RononDex/PipeItUp/README.md

# Pipe It Up

Das offizielle Code Repository für das FHNW IP12 Projekt "Pipe-It-Up".

## Dokumentation
Die Dokumentation für das Projekt kann hier auf [Confluence](https://www.cs.technik.fhnw.ch/confluence20/display/VT122106/IP12-21vt_Pipelinesystem) gefunden werden.
