RononDex/PipeItUp/3D_Print/Display-Attachment/STL/Display-Attachment.stl

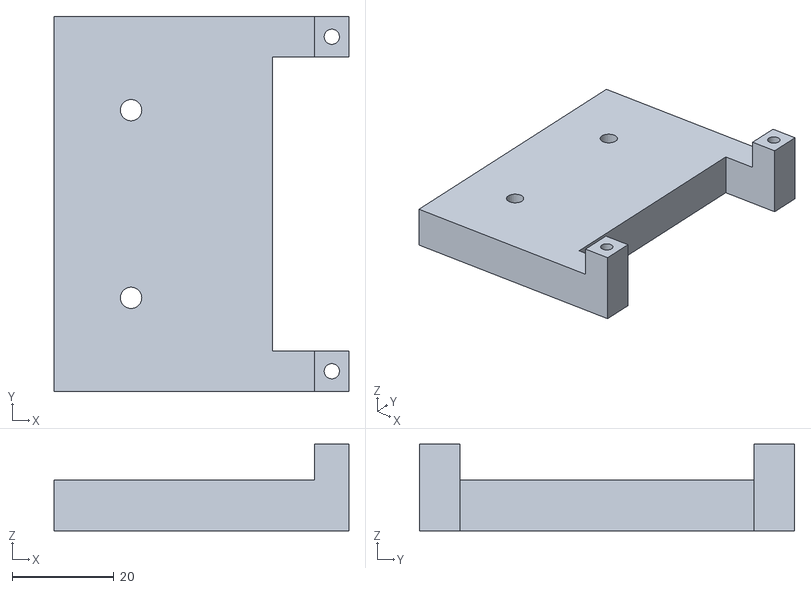
[picture p19: CAD file, 2022-05-26]
3D_Print/Display-Attachment/STL/Display-Attachment.stl
57.9 x 73.7 x 17.0
