RononDex/PipeItUp/3D_Print/Knoten/STL/Knoten_NR14.stl

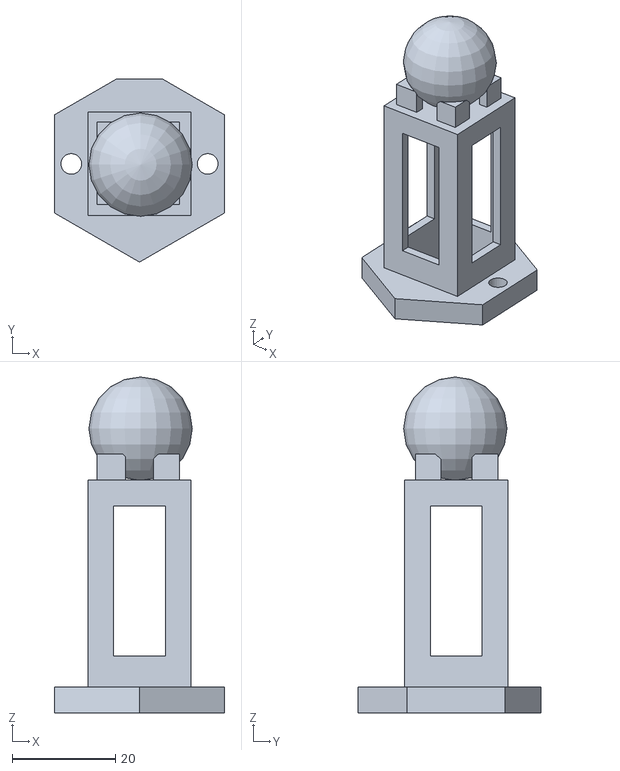
[picture p20: CAD file, 2022-05-26]
3D_Print/Knoten/STL/Knoten_NR14.stl
32.9 x 35.5 x 65.0
