RononDex/PipeItUp/3D_Print/PipeItUp_Logo/STL/PipeItUp_Logo.stl

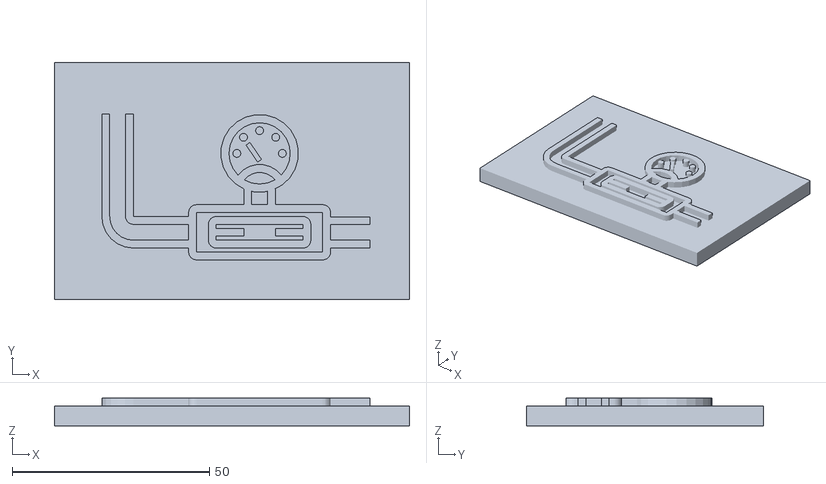
[picture p21: CAD file, 2022-05-26]
3D_Print/PipeItUp_Logo/STL/PipeItUp_Logo.stl
90.0 x 60.0 x 7.00
