RononDex/PipeItUp/3D_Print/Schiene/STL/Schiene.stl

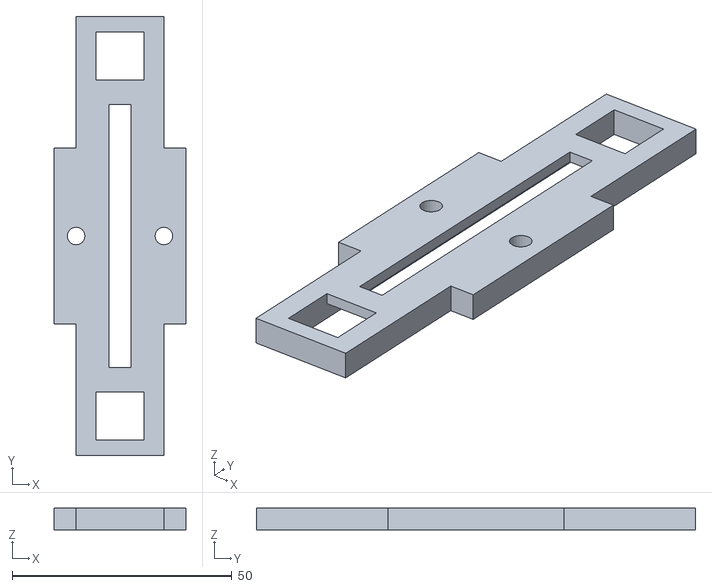
[picture p22: CAD file, 2022-05-26]
3D_Print/Schiene/STL/Schiene.stl
30.0 x 100.0 x 5.00
