RononDex/PipeItUp/3D_Print/Säule/STL/Säule.stl

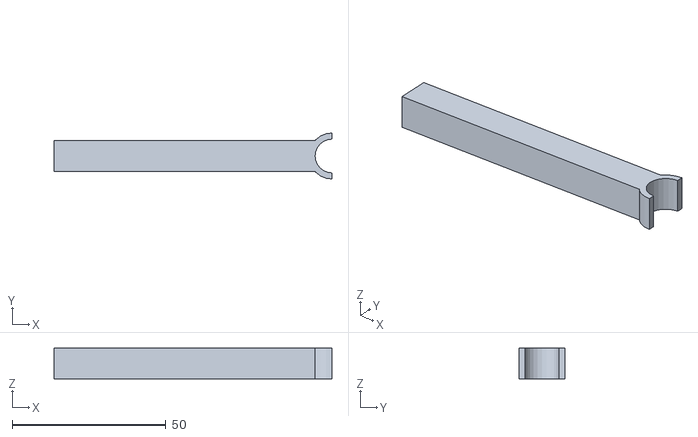
[picture p23: CAD file, 2022-05-26]
3D_Print/Säule/STL/Säule.stl
90.5 x 15.0 x 10.0
