RononDex/PipeItUp/3D_Print/Top-Platform/STL/Top-Platform.stl

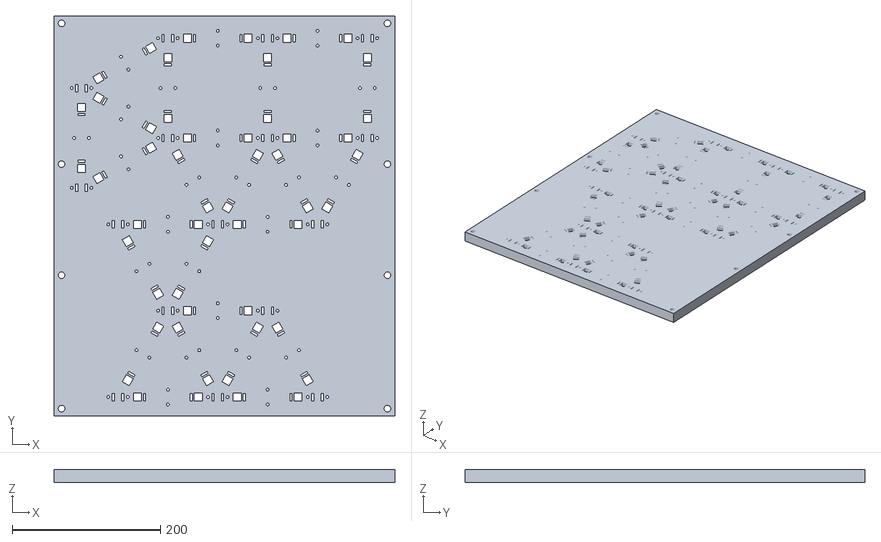
[picture p24: CAD file, 2022-05-26]
3D_Print/Top-Platform/STL/Top-Platform.stl
460.0 x 540.0 x 18.0
