RononDex/PipeItUp/3D_Print/Bottom-Platform/STL/Bottom-Platform_DRUCK_NR1.stl

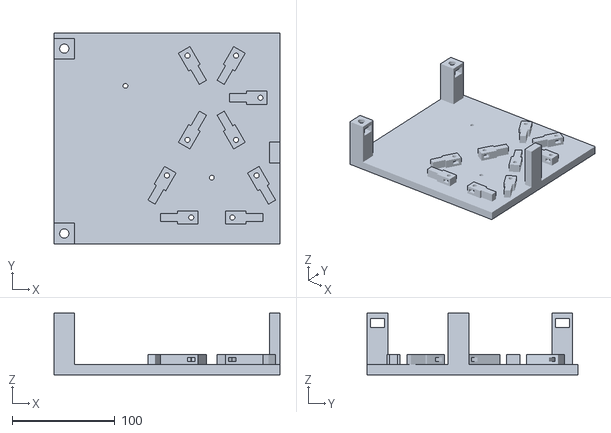
[picture p25: CAD file, 2022-05-26]
3D_Print/Bottom-Platform/STL/Bottom-Platform_DRUCK_NR1.stl
220.0 x 205.0 x 60.0
