RononDex/PipeItUp/3D_Print/Knoten/STL/Knoten_NR6.stl

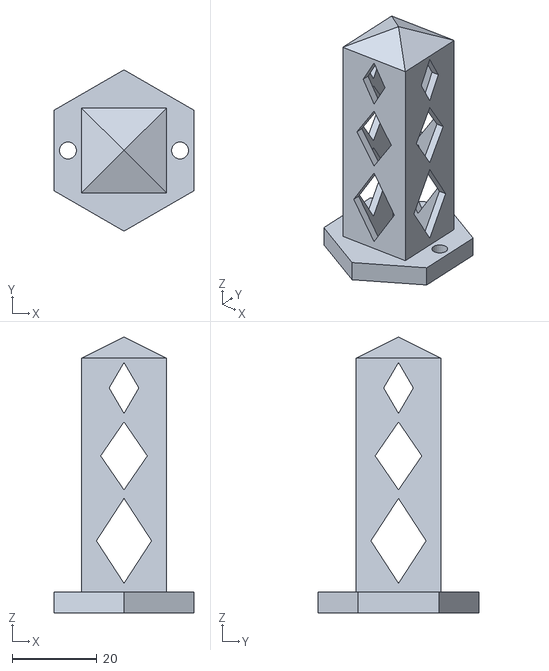
[picture p26: CAD file, 2022-05-26]
3D_Print/Knoten/STL/Knoten_NR6.stl
32.9 x 38.0 x 65.0
