RononDex/PipeItUp/3D_Print/Bottom-Platform/STL/Bottom-Platform_DRUCK_NR5.stl

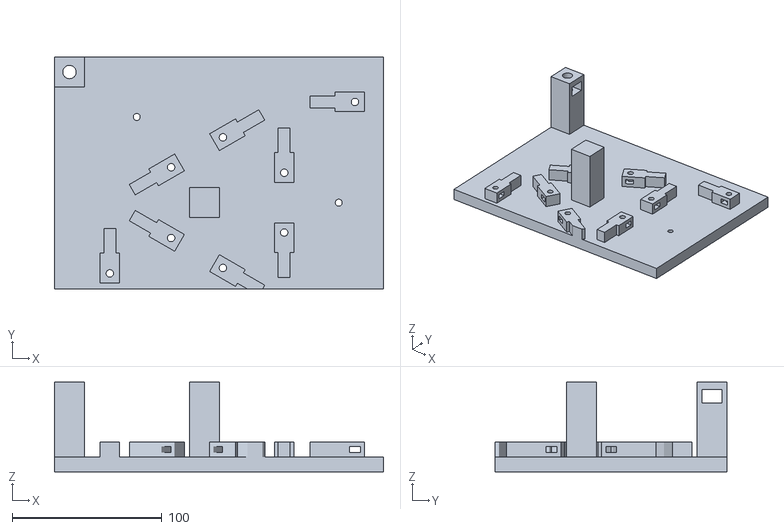
[picture p27: CAD file, 2022-05-26]
3D_Print/Bottom-Platform/STL/Bottom-Platform_DRUCK_NR5.stl
220.0 x 155.0 x 60.0
