RononDex/PipeItUp/3D_Print/Bottom-Platform/STL/Bottom-Platform_DRUCK_NR3.stl

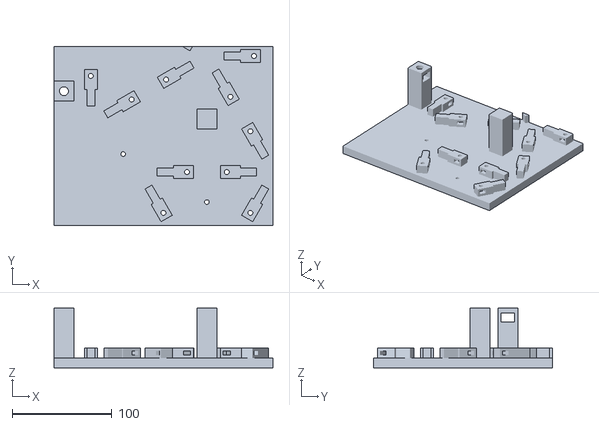
[picture p29: CAD file, 2022-05-26]
3D_Print/Bottom-Platform/STL/Bottom-Platform_DRUCK_NR3.stl
220.0 x 180.0 x 60.0
