RononDex/PipeItUp/3D_Print/Knoten/STL/Knoten_NR4.stl

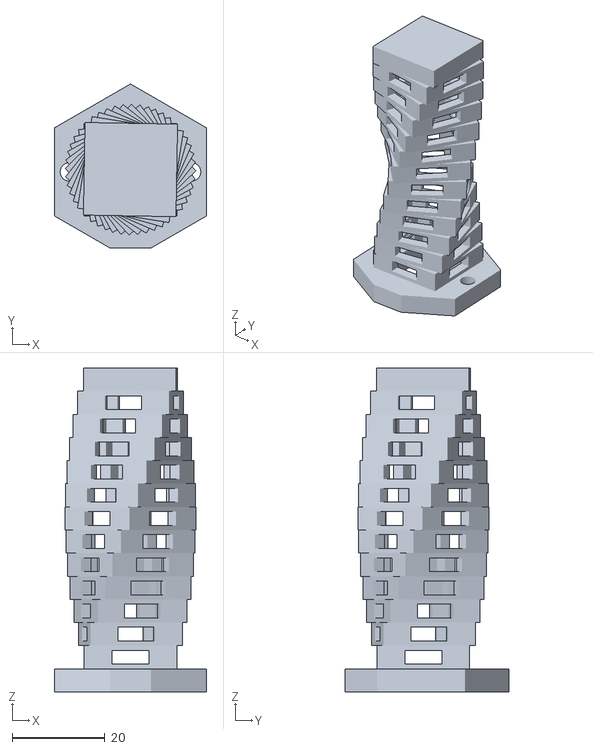
[picture p32: CAD file, 2022-05-26]
3D_Print/Knoten/STL/Knoten_NR4.stl
32.9 x 35.5 x 70.0
