RononDex/PipeItUp/3D_Print/Knoten/STL/Knoten_NR12.stl

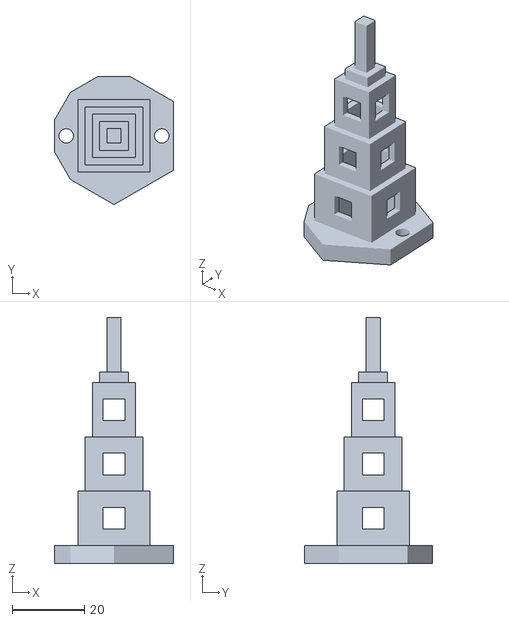
[picture p33: CAD file, 2022-05-26]
3D_Print/Knoten/STL/Knoten_NR12.stl
32.9 x 35.5 x 68.0
