RononDex/PipeItUp/3D_Print/Knoten/STL/Knoten_NR11.stl

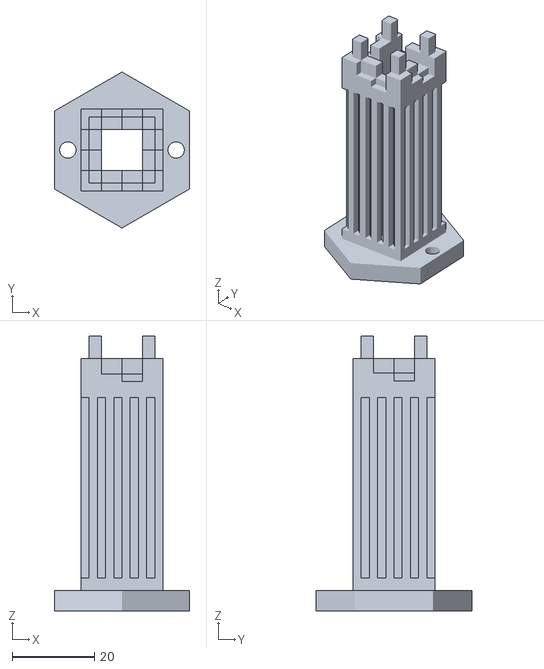
[picture p35: CAD file, 2022-05-26]
3D_Print/Knoten/STL/Knoten_NR11.stl
32.9 x 38.0 x 67.0
