RononDex/PipeItUp/3D_Print/Knoten/STL/Knoten_NR10.stl

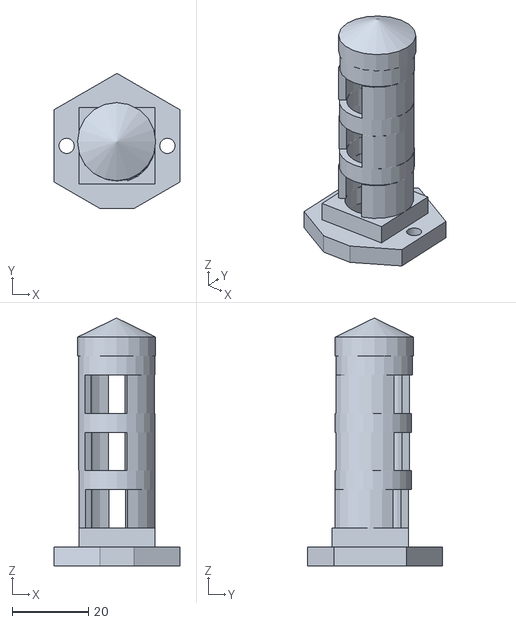
[picture p36: CAD file, 2022-05-26]
3D_Print/Knoten/STL/Knoten_NR10.stl
32.9 x 35.5 x 65.0
