RononDex/PipeItUp/3D_Print/Knoten/STL/Knoten_NR15.stl

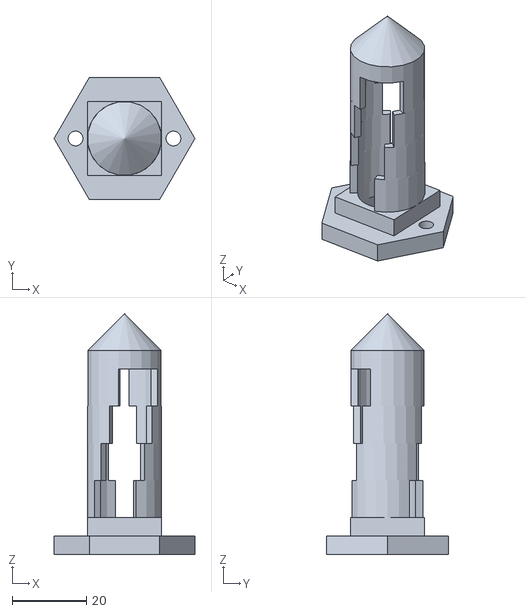
[picture p37: CAD file, 2022-05-26]
3D_Print/Knoten/STL/Knoten_NR15.stl
38.0 x 32.9 x 65.0
