RononDex/PipeItUp/3D_Print/Knoten/STL/Knoten_NR13.stl

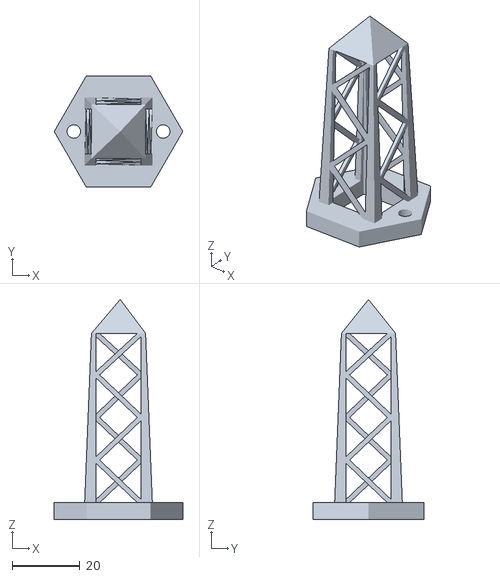
[picture p39: CAD file, 2022-05-26]
3D_Print/Knoten/STL/Knoten_NR13.stl
38.0 x 32.9 x 65.0
