RononDex/PipeItUp/3D_Print/Knoten/STL/Knoten_NR8.stl

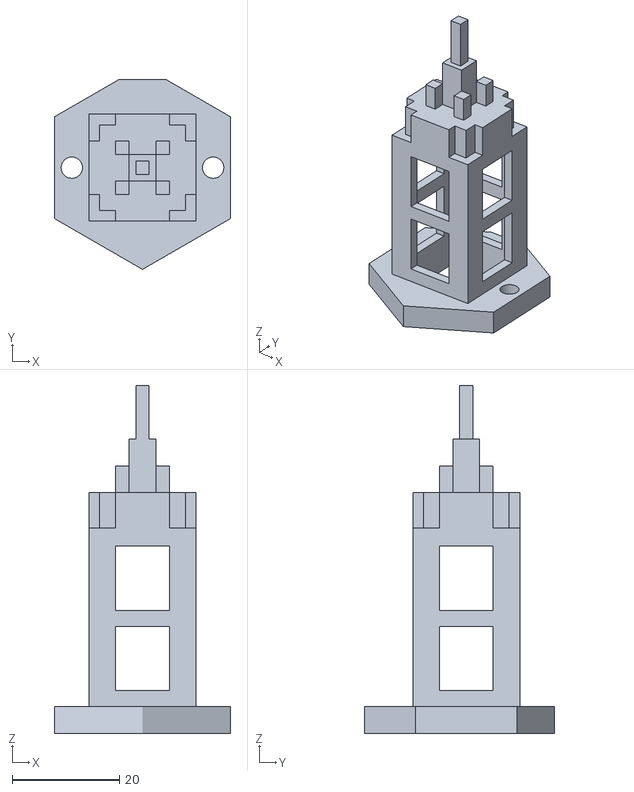
[picture p40: CAD file, 2022-05-26]
3D_Print/Knoten/STL/Knoten_NR8.stl
32.9 x 35.4 x 65.0
