RononDex/PipeItUp/3D_Print/Knoten/STL/Knoten_NR16.stl

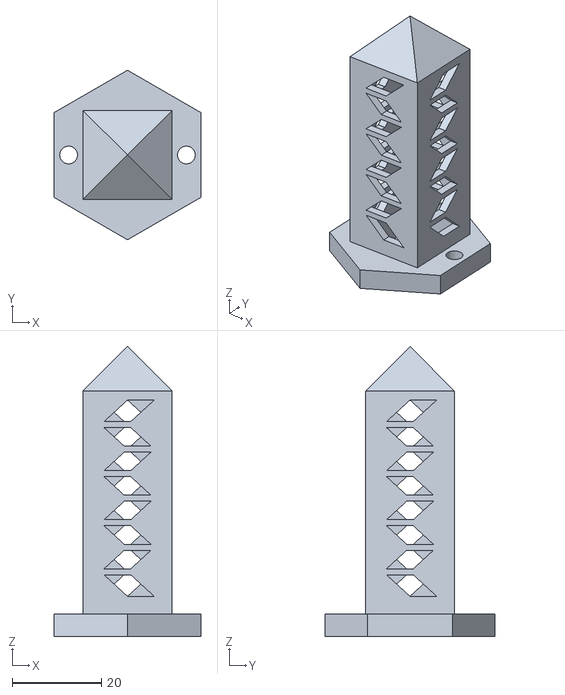
[picture p41: CAD file, 2022-05-26]
3D_Print/Knoten/STL/Knoten_NR16.stl
32.9 x 38.0 x 65.0
