RononDex/PipeItUp/3D_Print/Knoten/STL/Knoten_NR9.stl

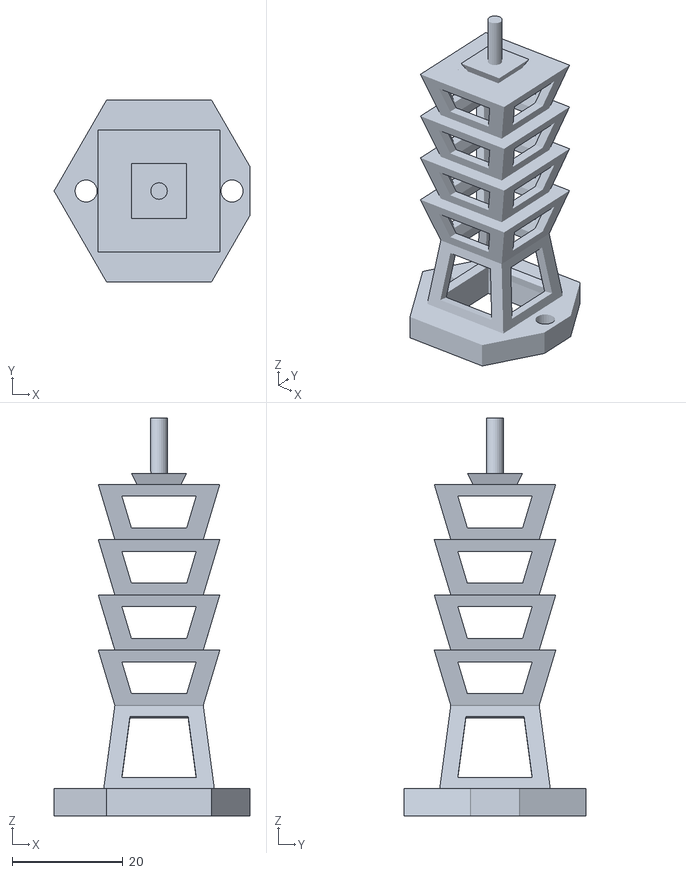
[picture p42: CAD file, 2022-05-26]
3D_Print/Knoten/STL/Knoten_NR9.stl
35.4 x 32.9 x 72.0
