RononDex/PipeItUp/3D_Print/Knoten/STL/Knoten_NR2.stl

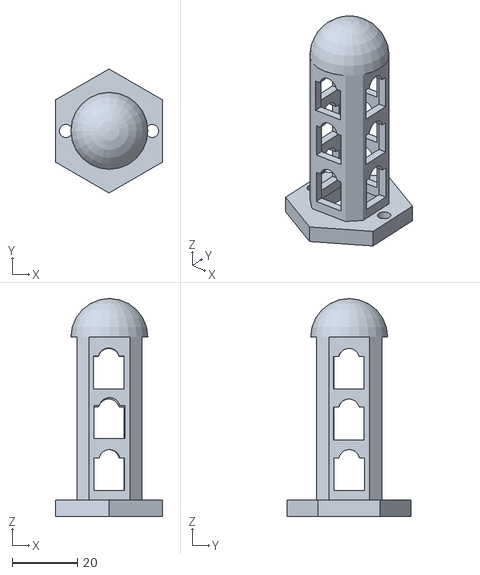
[picture p43: CAD file, 2022-05-26]
3D_Print/Knoten/STL/Knoten_NR2.stl
32.9 x 38.0 x 66.8
