RononDex/PipeItUp/(list of files, cad)

Other CAD files:
3D_Print/Bottom-Platform/STL/Bottom-Platform_DRUCK_NR4.stl
3D_Print/Knoten/STL/Knoten_NR5.stl
3D_Print/Bottom-Platform/00_Archiv/01_VERSION_KLEINE-STÜTZE_SCHMALL/00_ARCHIV/Bottom-Platform_DRAFT_VER1.skp
3D_Print/Bottom-Platform/00_Archiv/01_VERSION_KLEINE-STÜTZE_SCHMALL/Bottom-Platform_DRAFT_VER1.skp
3D_Print/Bottom-Platform/00_Archiv/02_VERSION_KLEINE-STÜTZE_BREIT/00_Archiv/Bottom-Platform_DRAFT_VER2 (1).skp
3D_Print/Bottom-Platform/00_Archiv/02_VERSION_KLEINE-STÜTZE_BREIT/00_Archiv/Bottom-Platform_DRAFT_VER2.skp
3D_Print/Bottom-Platform/00_Archiv/Bottom-Platform_DRAFT.skp
3D_Print/Bottom-Platform/00_Archiv/Bottom-Platform_FINAL (1).skp
3D_Print/Bottom-Platform/00_Archiv/DRUCK_WITHHELPER/Bottom-Platform_DRUCK_NR1_WITHHELPER.skp
3D_Print/Bottom-Platform/00_Archiv/DRUCK_WITHHELPER/Bottom-Platform_DRUCK_NR1_WITHHELPER.stl
3D_Print/Bottom-Platform/00_Archiv/DRUCK_WITHHELPER/Bottom-Platform_DRUCK_NR2_WITHHELPER.skp
3D_Print/Bottom-Platform/00_Archiv/DRUCK_WITHHELPER/Bottom-Platform_DRUCK_NR2_WITHHELPER.stl
3D_Print/Bottom-Platform/00_Archiv/TESTING/Bottom-Platform_TESTING.skp
3D_Print/Bottom-Platform/CAD/Bottom-Platform_DRAFT.skp
3D_Print/Bottom-Platform/CAD/Bottom-Platform_DRUCK_NR1.skp
3D_Print/Bottom-Platform/CAD/Bottom-Platform_DRUCK_NR2.skp
3D_Print/Bottom-Platform/CAD/Bottom-Platform_DRUCK_NR3.skp
3D_Print/Bottom-Platform/CAD/Bottom-Platform_DRUCK_NR4.skp
3D_Print/Bottom-Platform/CAD/Bottom-Platform_DRUCK_NR5.skp
3D_Print/Bottom-Platform/CAD/Bottom-Platform_DRUCK_NR6.skp
3D_Print/Display-Attachment/00_Archiv/Display-Attachment_DRAFT.skp
3D_Print/Display-Attachment/CAD/Display-Attachment_DRAFT.skp
3D_Print/Display-Attachment/CAD/Display-Attachment_FINAL.skp
3D_Print/Knoten/00_Archiv/Häuser/NOT_USED/Knoten Schiefer Pisaturm WIP.skp
3D_Print/Knoten/00_Archiv/Häuser/NOT_USED/PIU_NodeTurm Marc_Ver3_031221.skp
3D_Print/Knoten/00_Archiv/Häuser/NOT_USED/Runde Knoten.skp
3D_Print/Knoten/00_Archiv/Häuser/USED/4Dächiges_Gebäude_Clara_021221.skp
3D_Print/Knoten/00_Archiv/Häuser/USED/Gefängnis Knoten_Clara_051221.skp
3D_Print/Knoten/00_Archiv/Häuser/USED/Knoten Rocheturm.skp
3D_Print/Knoten/00_Archiv/Häuser/USED/Knoten Spirale Marc.skp
3D_Print/Knoten/00_Archiv/Häuser/USED/Knoten Turm 6.skp
3D_Print/Knoten/00_Archiv/Häuser/USED/Knoten Turm 7.skp
3D_Print/Knoten/00_Archiv/Häuser/USED/Knotengebäude 2.skp
3D_Print/Knoten/00_Archiv/Häuser/USED/Knotengebäude 3_Marc.skp
3D_Print/Knoten/00_Archiv/Häuser/USED/Kugel_Gebäude_Clara_021221.skp
3D_Print/Knoten/00_Archiv/Häuser/USED/Spitziges_Gebäude_Clara_021221.skp
3D_Print/Knoten/00_Archiv/Häuser/USED/Zylinde_SpiralFenster_Clara_021221.skp
3D_Print/Knoten/00_Archiv/Häuser/USED/Zylinder_Gebäude_Clara_021221.skp
3D_Print/Knoten/00_Archiv/Häuser/USED/halbkugeldach_Turm_Clara_031221.skp
3D_Print/Knoten/00_Archiv/Knoten_DRUCK_2.skp
3D_Print/Knoten/00_Archiv/Knoten_FINAL/Variante_1/Knoten_1_FINAL.skp
3D_Print/Knoten/00_Archiv/Knoten_FINAL/Variante_1/Knoten_2_FINAL.skp
3D_Print/Knoten/00_Archiv/Knoten_FINAL/Variante_1/Knoten_3_FINAL.skp
3D_Print/Knoten/00_Archiv/Knoten_FINAL/Variante_1/Knoten_4_FINAL.skp
3D_Print/Knoten/00_Archiv/Knoten_FINAL/Variante_1/Knoten_5_FINAL.skp
3D_Print/Knoten/00_Archiv/Knoten_FINAL/Variante_1/Knoten_6_FINAL.skp
3D_Print/Knoten/00_Archiv/Knoten_FINAL/Variante_1/Knoten_7_FINAL.skp
3D_Print/Knoten/00_Archiv/Knoten_FINAL/Variante_1/Knoten_8_FINAL.skp
3D_Print/Knoten/00_Archiv/Knoten_FINAL/Variante_2/Knoten_9_FINAL.skp
3D_Print/Knoten/00_Archiv/Knoten_FINAL/Variante_3/Knoten_10_FINAL.skp
3D_Print/Knoten/00_Archiv/Knoten_FINAL/Variante_3/Knoten_11_FINAL.skp
3D_Print/Knoten/00_Archiv/Knoten_FINAL/Variante_4/Knoten_12_FINAL.skp
3D_Print/Knoten/00_Archiv/Knoten_FINAL/Variante_4/Knoten_13_FINAL.skp
3D_Print/Knoten/00_Archiv/Sockel_&_Türme_DRAFT.skp
3D_Print/Knoten/00_Archiv/Sockel_&_Türme_FINAL (1).skp
3D_Print/Knoten/00_Archiv/Sockel_&_Türme_FINAL.skp
3D_Print/Knoten/00_Archiv/Sockel_Varianten/4-Eckig/Sockel_Variante_1/4-Eckig_Sockel_Variante_1_DRAFT.skp
3D_Print/Knoten/00_Archiv/Sockel_Varianten/4-Eckig/Sockel_Variante_1/4-Eckig_Sockel_Variante_1_FINAL.skp
3D_Print/Knoten/00_Archiv/Sockel_Varianten/4-Eckig/Sockel_Variante_2/4-Eckig_Sockel_Variante_2_DRAFT.skp
3D_Print/Knoten/00_Archiv/Sockel_Varianten/4-Eckig/Sockel_Variante_2/4-Eckig_Sockel_Variante_2_FINAL.skp
3D_Print/Knoten/00_Archiv/Sockel_Varianten/4-Eckig/Sockel_Variante_3/4-Eckig_Sockel_Variante_3_DRAFT.skp
3D_Print/Knoten/00_Archiv/Sockel_Varianten/4-Eckig/Sockel_Variante_3/4-Eckig_Sockel_Variante_3_FINAL.skp
3D_Print/Knoten/00_Archiv/Sockel_Varianten/4-Eckig/Sockel_Variante_4/4-Eckig_Sockel_Variante_4_DRAFT.skp
3D_Print/Knoten/00_Archiv/Sockel_Varianten/4-Eckig/Sockel_Variante_4/4-Eckig_Sockel_Variante_4_FINAL.skp
3D_Print/Knoten/00_Archiv/Sockel_Varianten/4-Eckig/Sockel_Variante_5/4-Eckig_Sockel_Variante_5_DRAFT.skp
3D_Print/Knoten/00_Archiv/Sockel_Varianten/4-Eckig/Sockel_Variante_5/4-Eckig_Sockel_Variante_5_FINAL.skp
3D_Print/Knoten/00_Archiv/Sockel_Varianten/4-Eckig/Sockel_Variante_6/4-Eckig_Sockel_Variante_6_DRAFT.skp
3D_Print/Knoten/00_Archiv/Sockel_Varianten/4-Eckig/Sockel_Variante_6/4-Eckig_Sockel_Variante_6_FINAL.skp
3D_Print/Knoten/00_Archiv/Sockel_Varianten/8-Eckig/Sockel_Variante_1/8-Eckig_Sockel_Variante_1_DRAFT.skp
3D_Print/Knoten/00_Archiv/Sockel_Varianten/8-Eckig/Sockel_Variante_1/8-Eckig_Sockel_Variante_1_FINAL.skp
3D_Print/Knoten/00_Archiv/Sockel_Varianten/Ganz-Rund/Sockel_Variante_1/Ganz-Rund_Sockel_Variante_1_DRAFT.skp
3D_Print/Knoten/00_Archiv/Sockel_Varianten/Ganz-Rund/Sockel_Variante_1/Ganz-Rund_Sockel_Variante_1_FINAL.skp
3D_Print/Knoten/00_Archiv/Sockel_Varianten/Ganz-Rund/Sockel_Variante_3/Ganz-Rund_Sockel_Variante_3_DRAFT.skp
3D_Print/Knoten/00_Archiv/Sockel_Varianten/Ganz-Rund/Sockel_Variante_3/Ganz-Rund_Sockel_Variante_3_FINAL.skp
3D_Print/Knoten/00_Archiv/Sockel_Varianten/Ganz-Rund/Sockel_Variante_4/Ganz-Rund_Sockel_Variante_4_DRAFT.skp
3D_Print/Knoten/00_Archiv/Sockel_Varianten/Ganz-Rund/Sockel_Variante_4/Ganz-Rund_Sockel_Variante_4_FINAL.skp
3D_Print/Knoten/00_Archiv/Sockel_Varianten/Halb-Rund/Sockel_Variante_2/Rund_Sockel_Variante_2_DRAFT.skp
3D_Print/Knoten/00_Archiv/Sockel_Varianten/Halb-Rund/Sockel_Variante_2/Rund_Sockel_Variante_2_FINAL.skp
3D_Print/Knoten/CAD/Sockel_&_Türme_FINAL.skp
3D_Print/Knoten/STL/00_Archiv/DRUCK_1/Knoten_DRUCK_1.skp
3D_Print/Knoten/STL/00_Archiv/DRUCK_2/Knoten_DRUCK_2.skp
3D_Print/PipeItUp_Logo/CAD/PipeItUp_Logo.skp
3D_Print/Schiene/CAD/Schiene_DRAFT.skp
3D_Print/Schiene/CAD/Schiene_FINAL.skp
3D_Print/Säule/CAD/Säule_DRAFT.skp
3D_Print/Säule/CAD/Säule_FINAL.skp
3D_Print/Top-Platform/00_Archiv/Top-Platform_DRAFT.skp
3D_Print/Top-Platform/00_Archiv/Top-Platform_FINAL.skp
3D_Print/Top-Platform/00_Archiv/Top-Platform_Final_Mittwoch.skp
3D_Print/Top-Platform/CAD/Top-Platform_DRAFT.skp
3D_Print/Top-Platform/CAD/Top-Platform_DRUCK.skp
3D_Print/Whole_Product.skp
