RononDex/PipeItUp/3D_Print/Bottom-Platform/Bottom-Platform_Übersicht.docx

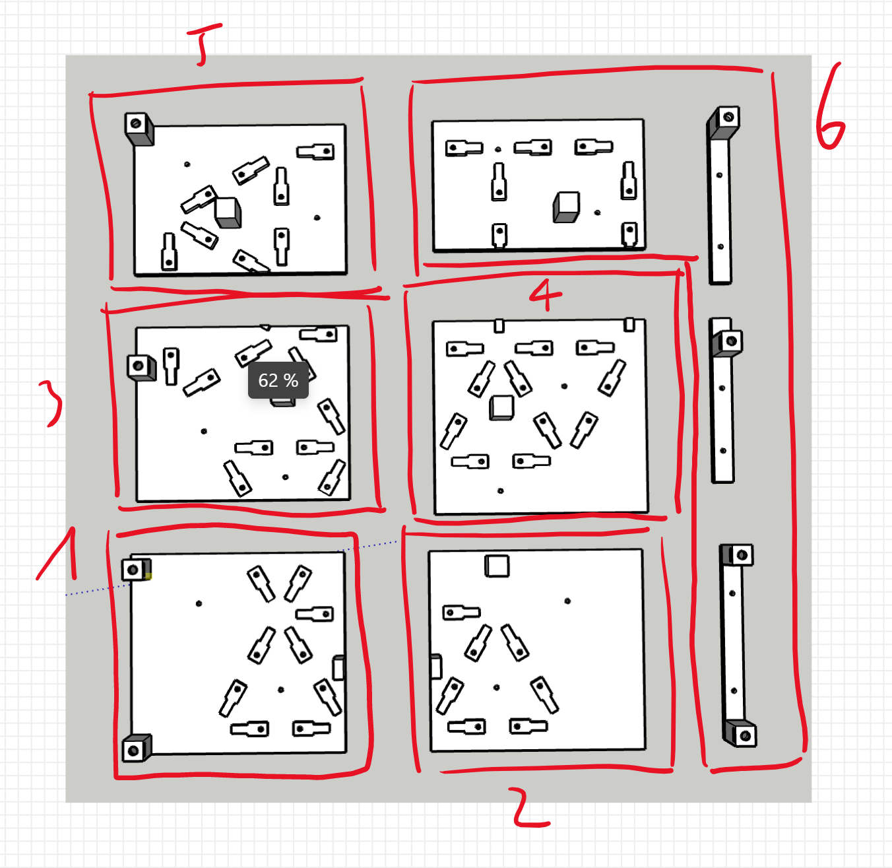
[picture p64: figure]
