RononDex/PipeItUp/3D_Print/Knoten/Knoten_Übersicht.pdf

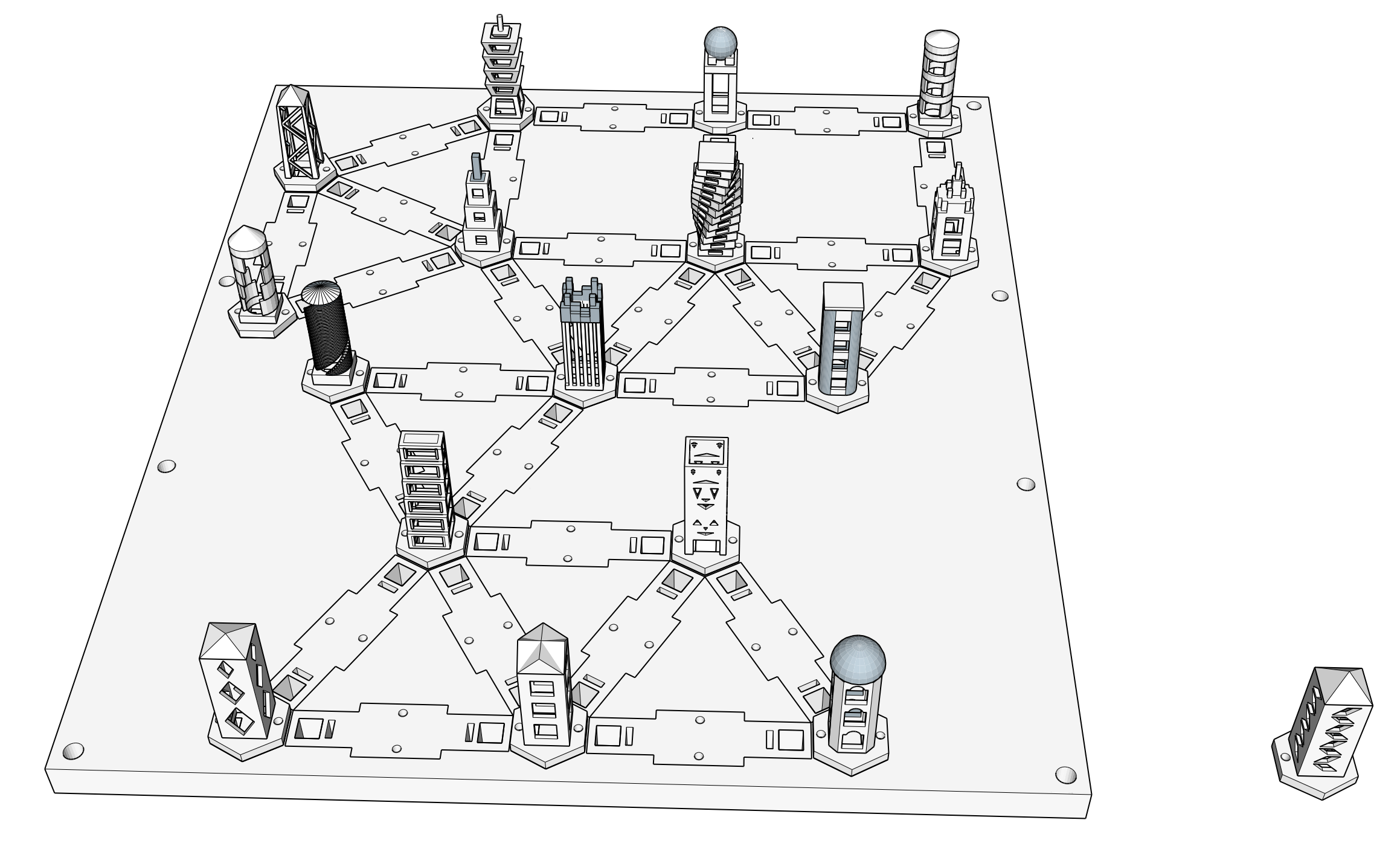
[picture p65: page 1]

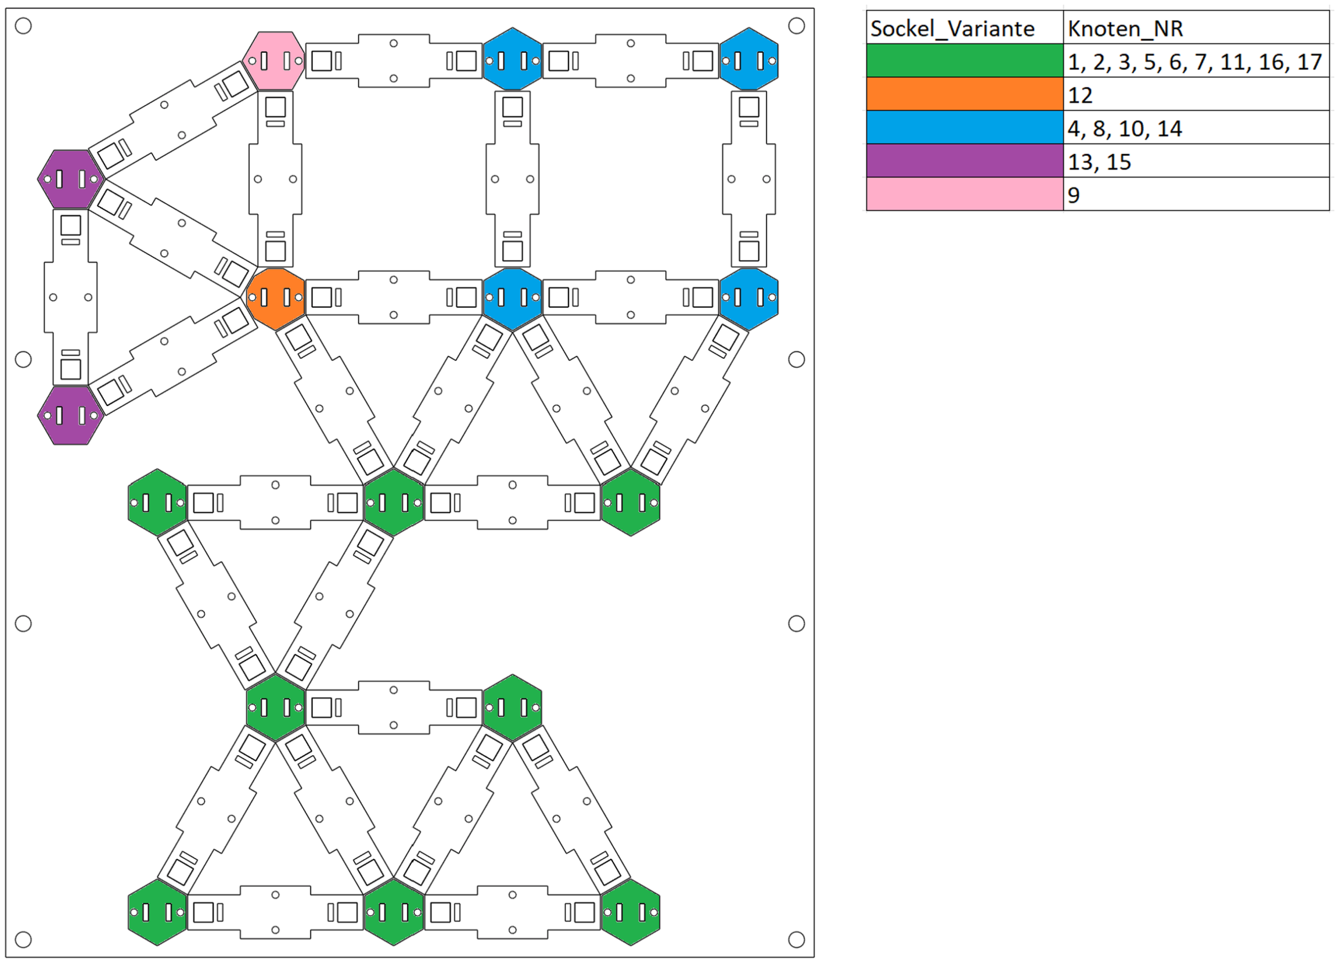
[picture p66: page 3]
