RononDex/PipeItUp/3D_Print/Knoten/00_Archiv/Knoten_Legende.xlsx

Knoten_NR | Bild | Knoten_NR | Bild | Knoten_NR | Bild
1 |  | 7 |  | 13
2 |  | 8 |  | 14
3 |  | 9 |  | 15
4 |  | 10 |  | 16
5 |  | 11 |  | 17
6 |  | 12
