RononDex/PipeItUp/3D_Print/Knoten/STL/00_Archiv/DRUCK_1/Knoten_welche_neu_gedruckt_werden_müssen.docx

Knoten | Grund für neuen Druck

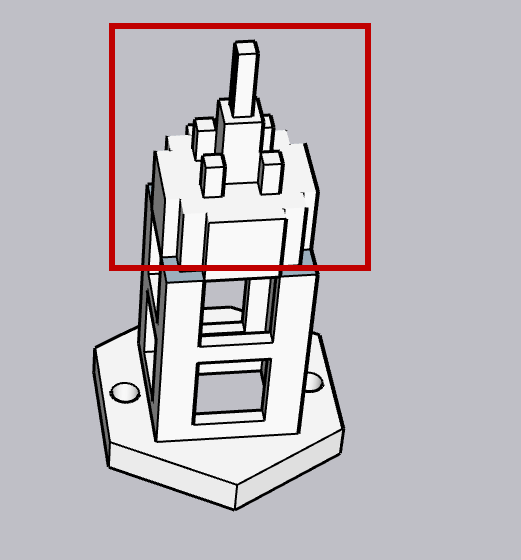
[picture p67: figure]

| Der obere Teil (rot markiert) ist nicht befestigt. - Neu designen und drucken lassen

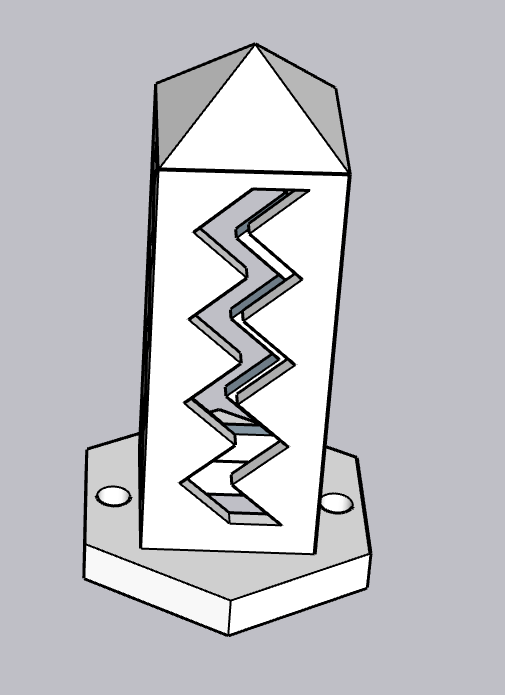
[picture p68: figure]

| Schlechte Druckqualität - Neu drucken lassen; ohne Support

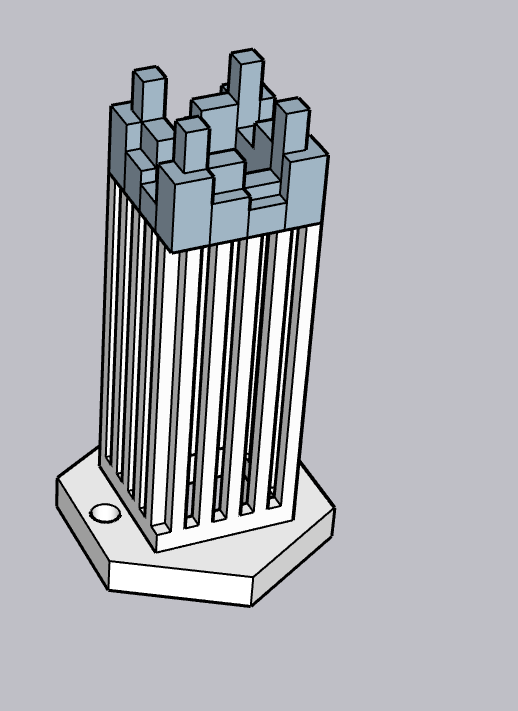
[picture p69: figure]

| Schlechte Druckqualität - Neu drucken lassen beim Tino; ohne Support

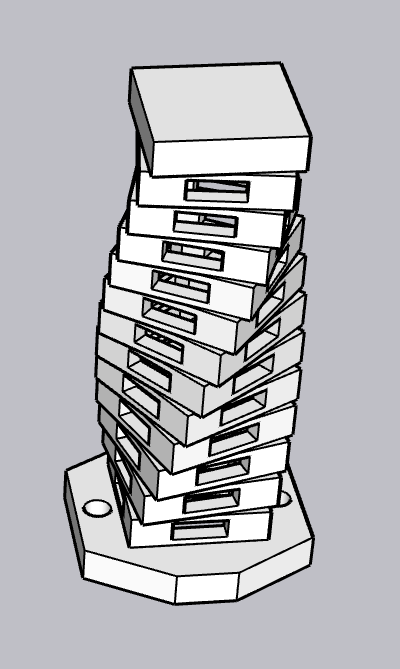
[picture p70: figure]

| Schlechte Druckqualität Neu drucken lassen beim Tino; ohne Support
