RononDex/PipeItUp/3D_Print/Bottom-Platform/00_Archiv/01_VERSION_KLEINE-STÜTZE_SCHMALL/Bottom-Platform_MAKERSTUDIO.pdf

## 10ÊmmÊHöhe

### 1. Druck:Ê1xÊ220x135mmÊ+Ê2xÊ170x20mmÊ+Ê1xÊ200x20mm

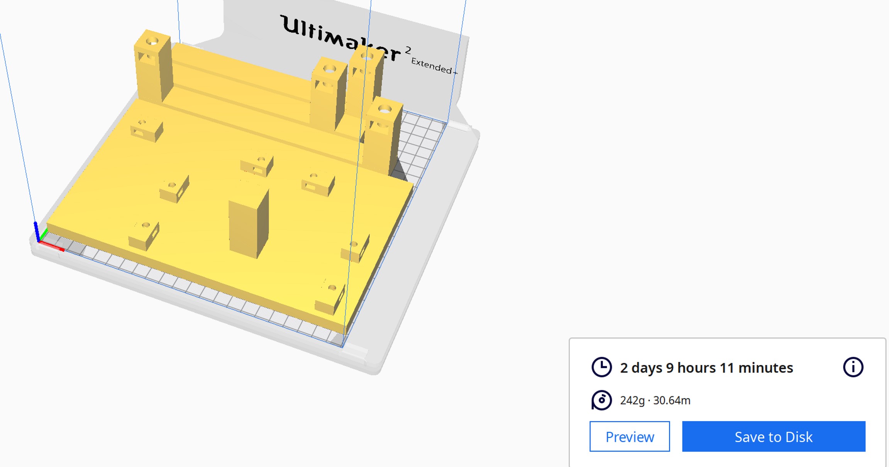
[picture p71: figure]
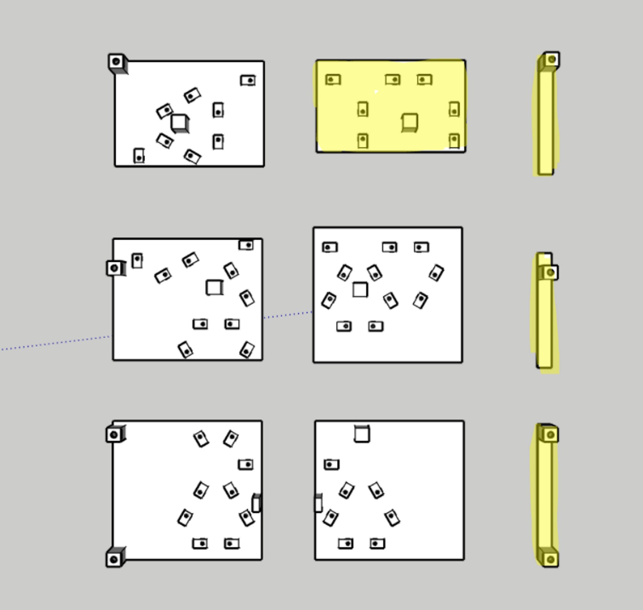
[picture p72: figure]

DRUCKDAUER: 57H 11MIN

### 2. Druck:Ê1xÊ220x205mm

# Bottom-Platform Druck

Donnerstag,Ê31.ÊMärzÊ2022 22:03

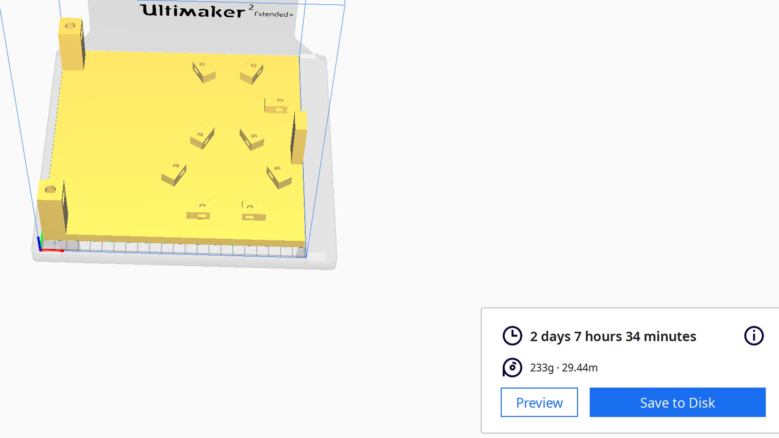
[picture p73: figure]
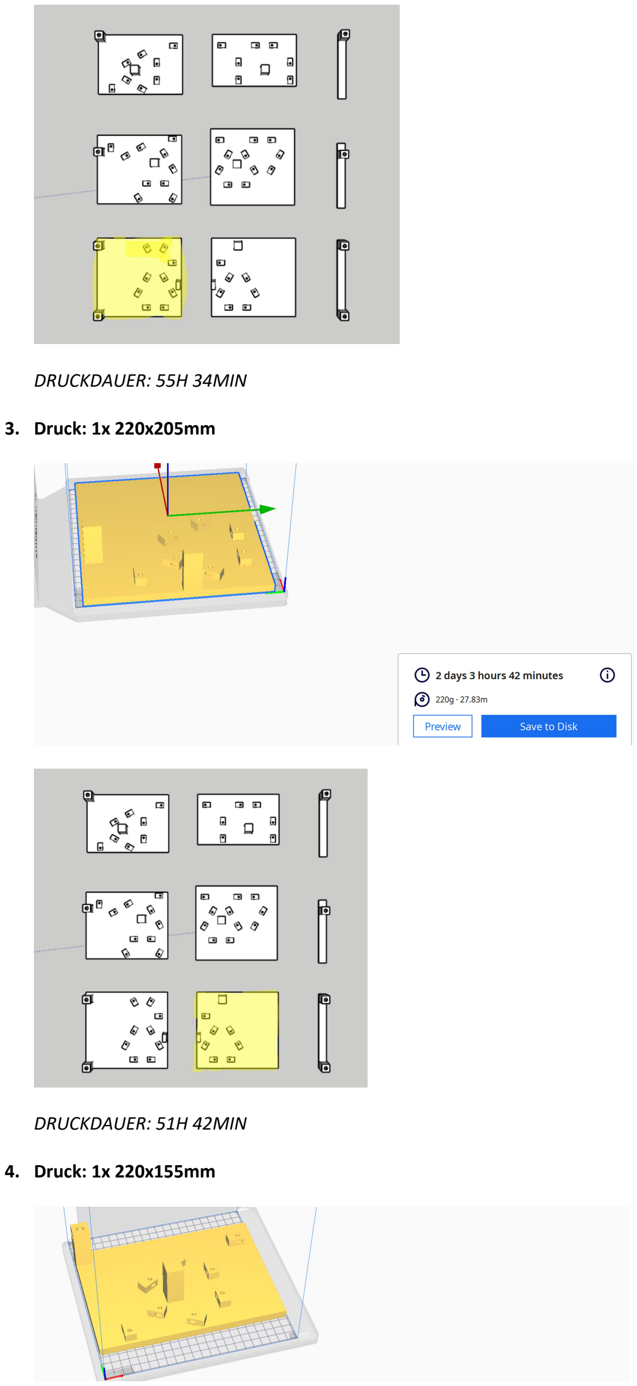
[picture p74: page 2]

DRUCKDAUER: 55H 34MIN

### 3. Druck:Ê1xÊ220x205mm

DRUCKDAUER: 51H 42MIN

### 4. Druck:Ê1xÊ220x155mm

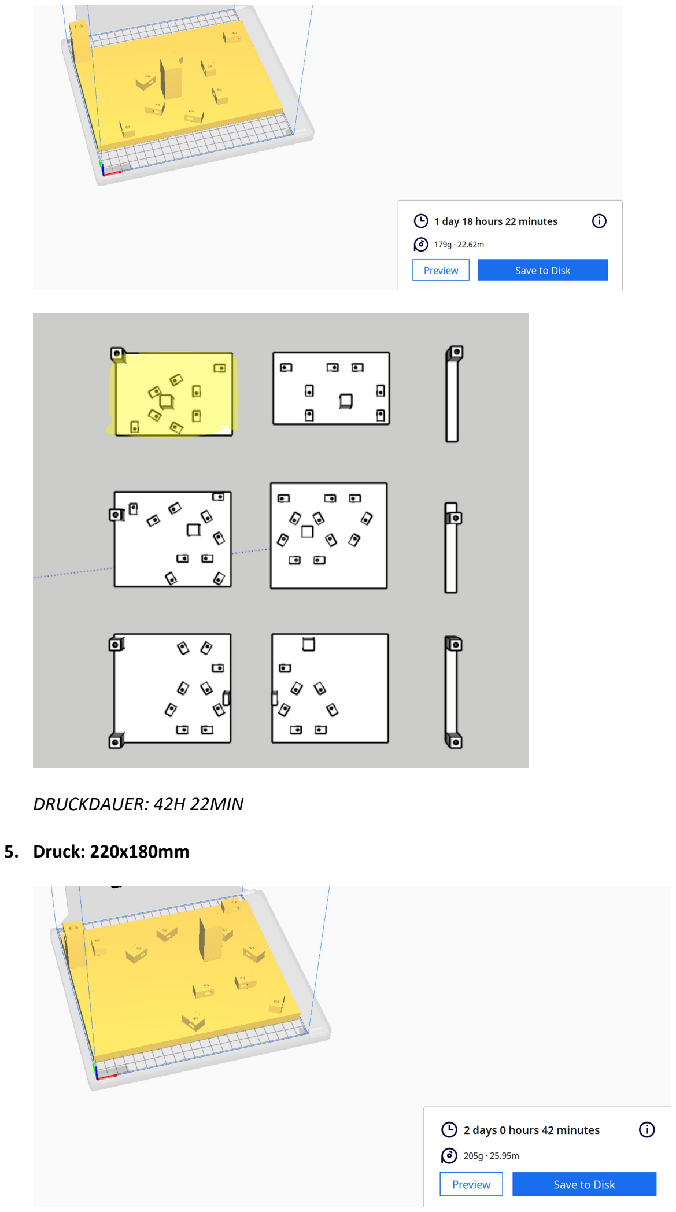
[picture p75: page 3]

DRUCKDAUER: 42H 22MIN

### 5. Druck:Ê220x180mm

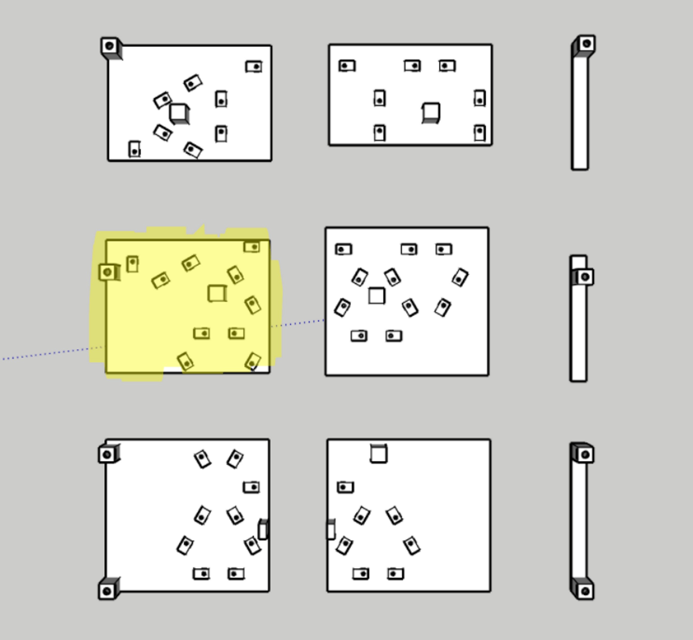
[picture p76: figure]

DRUCKDAUER: 48H 42MIN

### 6. Druck:Ê220x200mm

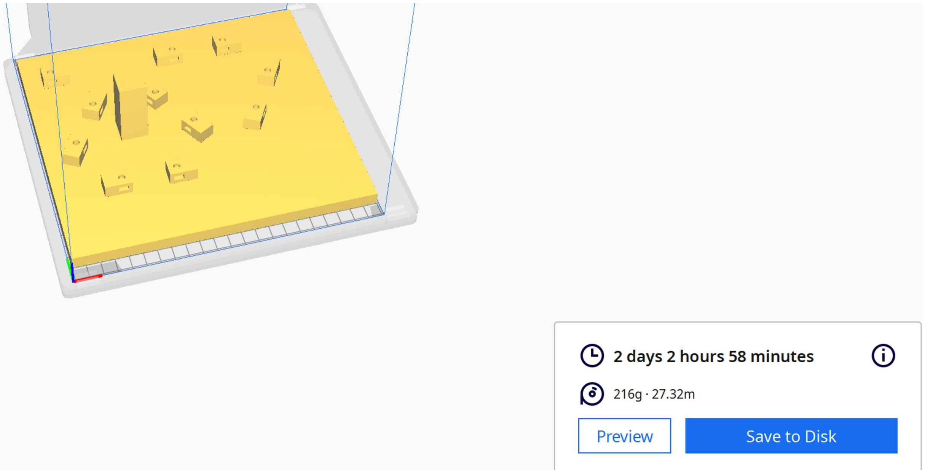
[picture p77: figure]

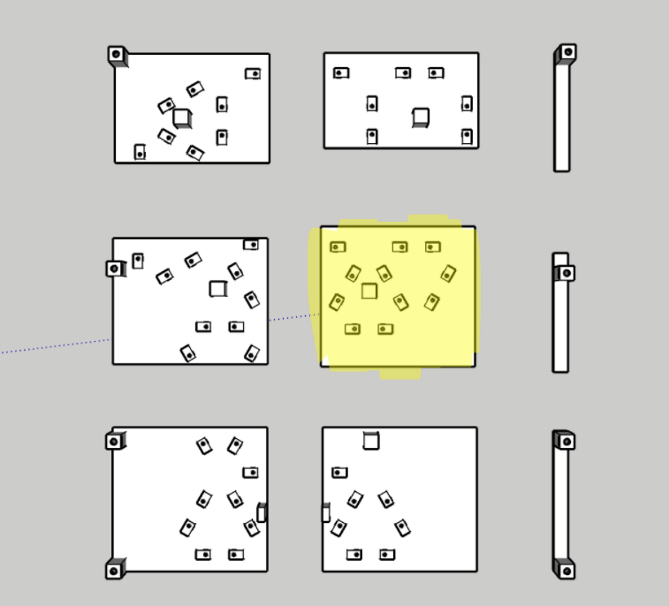
[picture p78: figure]

DRUCKDAUER: 50H 58MIN
