RononDex/PipeItUp/3D_Print/3D_Print_Übersicht.pdf

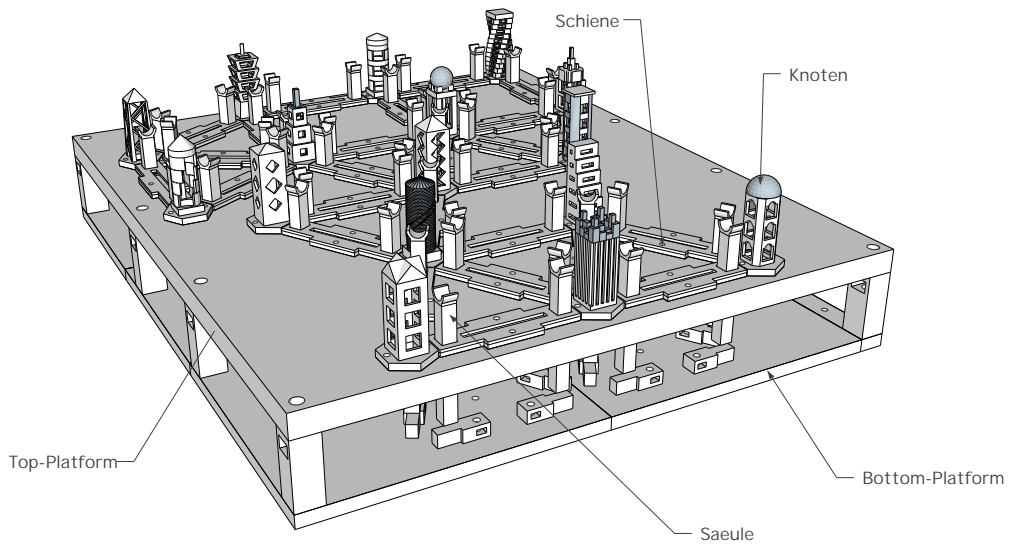
[picture p79: page 1]
Knoten; Schiene; Saeule; Top-Platform; Bottom-Platform
