RononDex/PipeItUp/3D_Print/Top-Platform/3D_Print_Übersicht.pdf

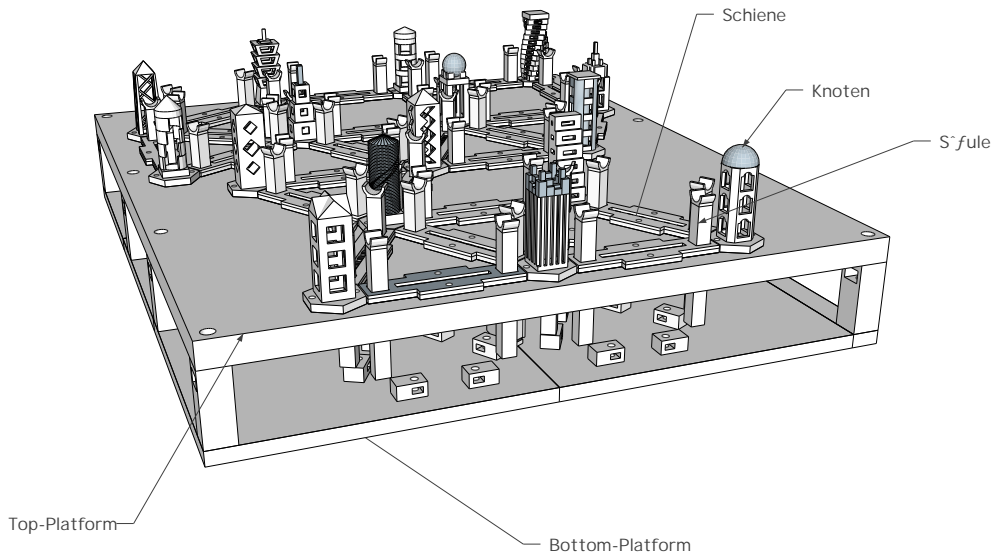
[picture p80: page 1]
Knoten; Sˆƒule; Schiene; Bottom-Platform; Top-Platform
