RononDex/PipeItUp/3D_Print/Knoten/00_Archiv/Knoten_LEGENDE.pdf

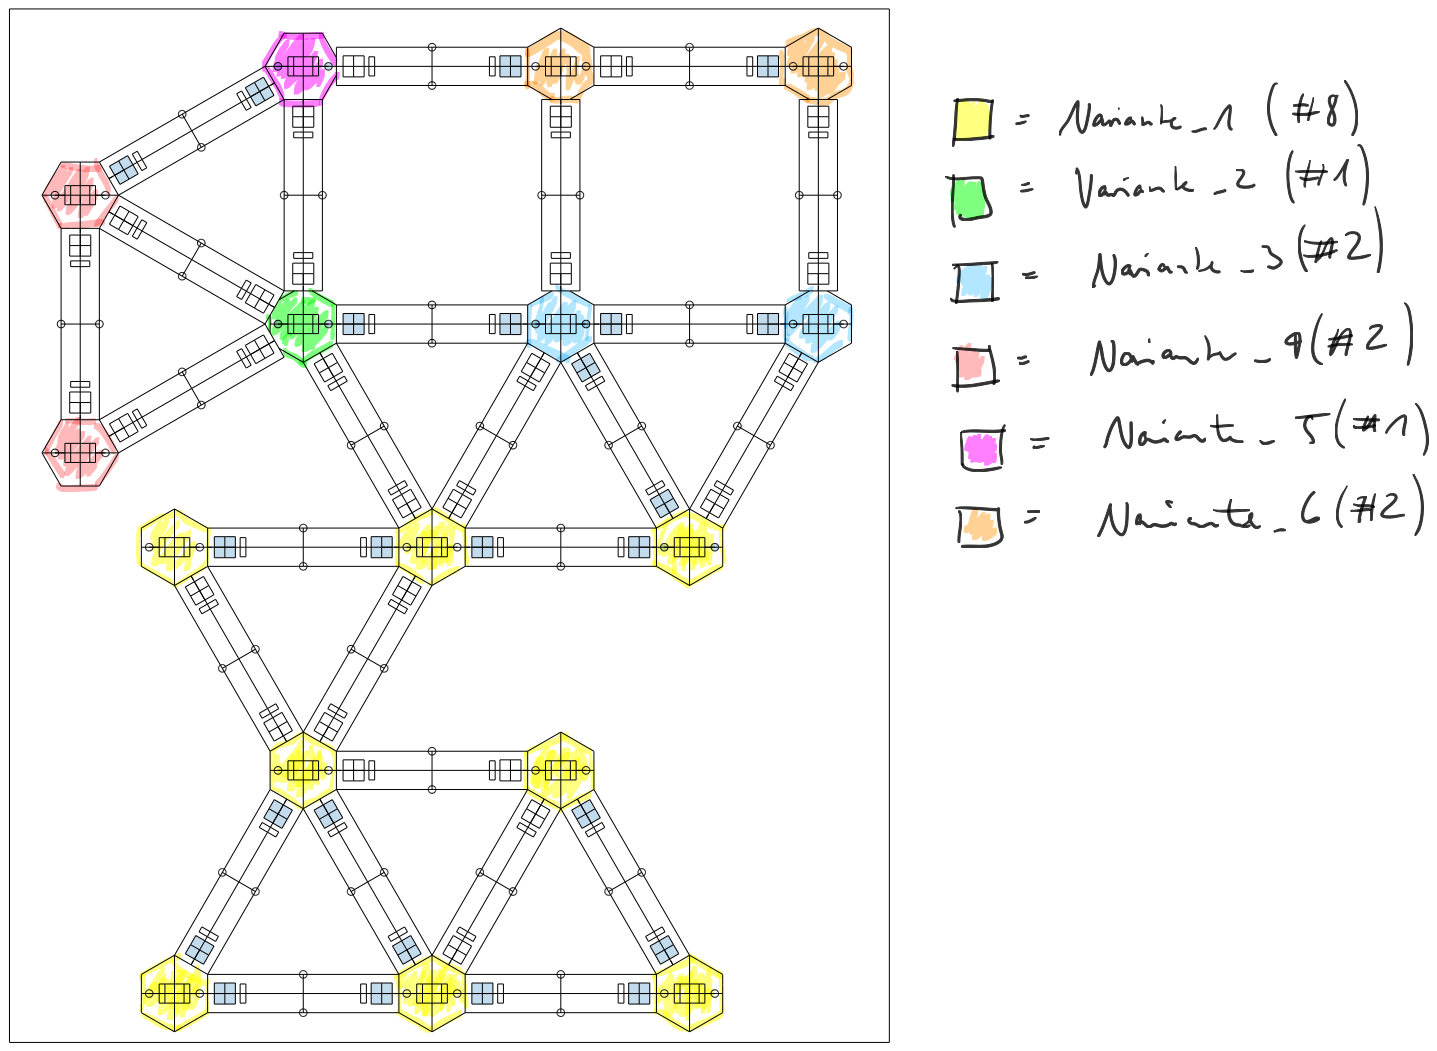
[picture p81: page 1]
