RononDex/PipeItUp/3D_Print/Knoten/00_Archiv/Whole_Product.pdf

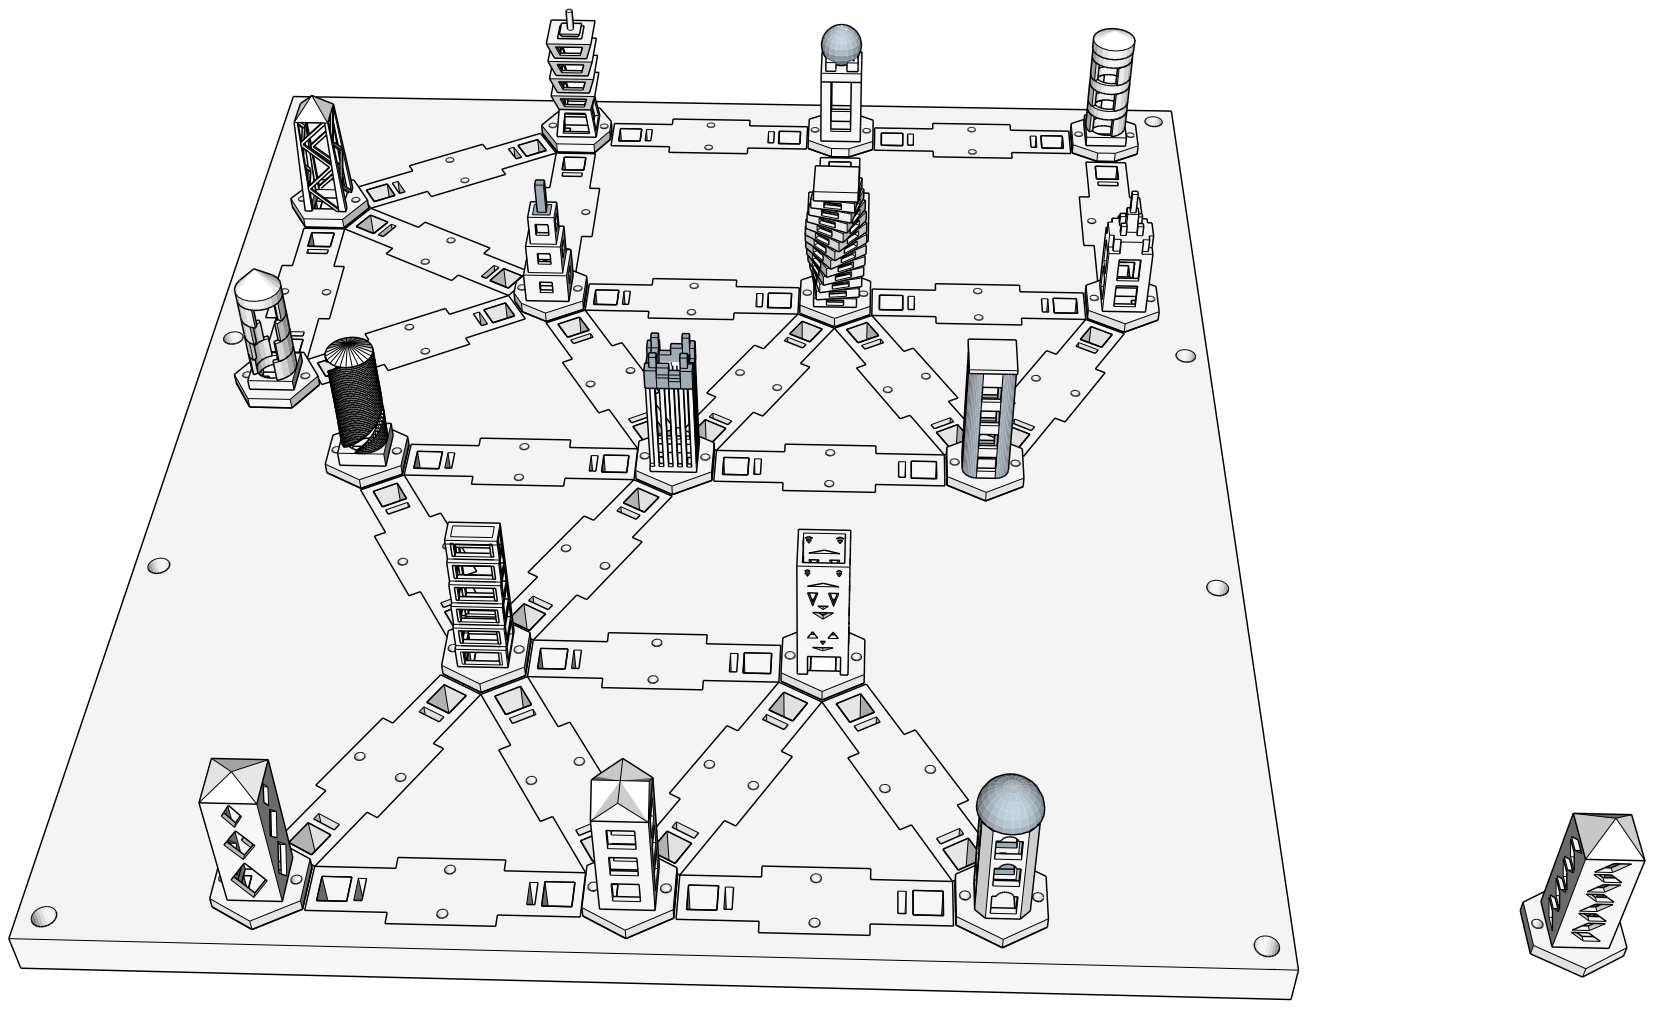
[picture p82: page 1]
