RononDex/PipeItUp/(commit log)

2021-11-29 VT122105-55: Switch to packages dir before downloading autohotspot
2021-11-30 VT122106-57: Setup sample JavaFX app
2021-12-03 remove print lines
2021-12-15 Vt122106 72 led button functions and openjfx
2022-04-06 Vt122106 58 add di
2022-05-25 3D Print-Dateien
    [4-Eckig_Sockel_Variante_1_DRAFT.skp, 4-Eckig_Sockel_Variante_1_FINAL.skp, 4-Eckig_Sockel_Variante_2_DRAFT.skp, 4-Eckig_Sockel_Variante_2_FINAL.skp, 4-Eckig_Sockel_Variante_3_DRAFT.skp, 4-Eckig_Sockel_Variante_3_FINAL.skp, 4-Eckig_Sockel_Variante_4_DRAFT.skp, 4-Eckig_Sockel_Variante_4_FINAL.skp]
2022-05-25 switch ico
2022-05-26 Move files to normal git again
    [4-Eckig_Sockel_Variante_1_DRAFT.skp, 4-Eckig_Sockel_Variante_1_FINAL.skp, 4-Eckig_Sockel_Variante_2_DRAFT.skp, 4-Eckig_Sockel_Variante_2_FINAL.skp, 4-Eckig_Sockel_Variante_3_DRAFT.skp, 4-Eckig_Sockel_Variante_3_FINAL.skp, 4-Eckig_Sockel_Variante_4_DRAFT.skp, 4-Eckig_Sockel_Variante_4_FINAL.skp]
